JuliaDominiak/SpiderHand/3D Models/Construction/Part_2.stl

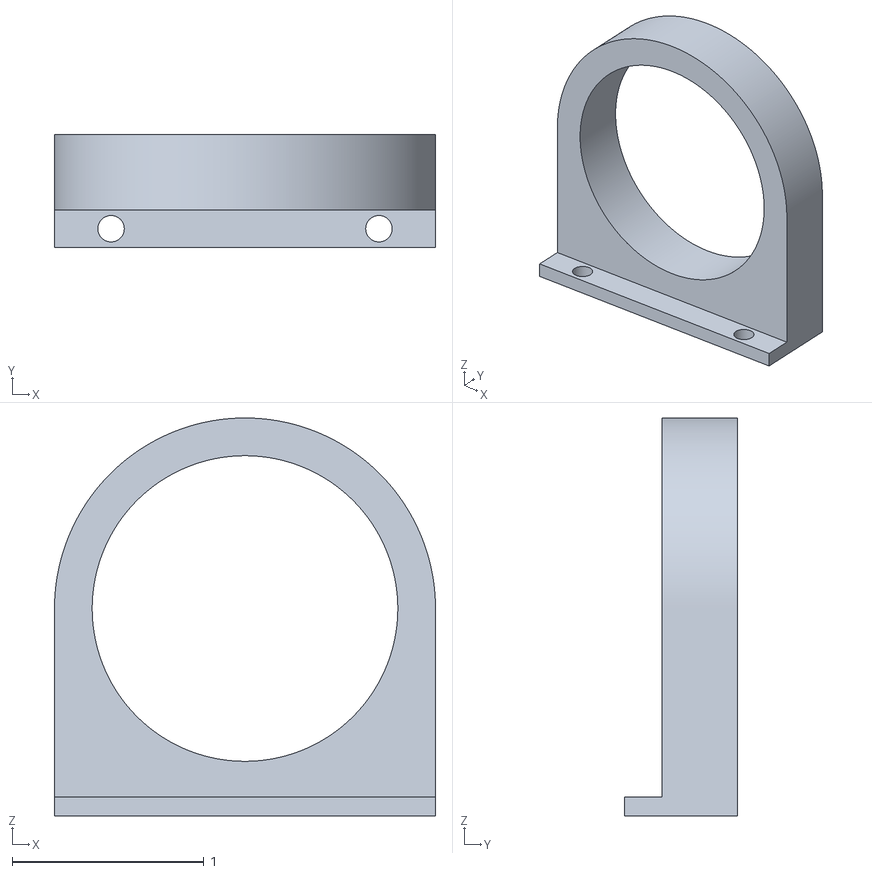
[picture p5: CAD file, 2020-11-13]
3D Models/Construction/Part_2.stl
1.99 x 0.591 x 2.08
