JuliaDominiak/SpiderHand/3D Models/Fingertips/Touch_3.stl

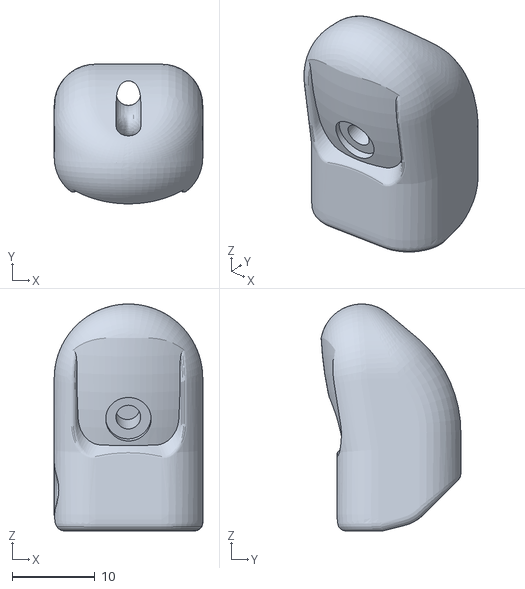
[picture p6: CAD file, 2020-11-13]
3D Models/Fingertips/Touch_3.stl
18.0 x 16.9 x 27.5
