JuliaDominiak/SpiderHand/3D Models/Sensors/bendlabs_2.stl

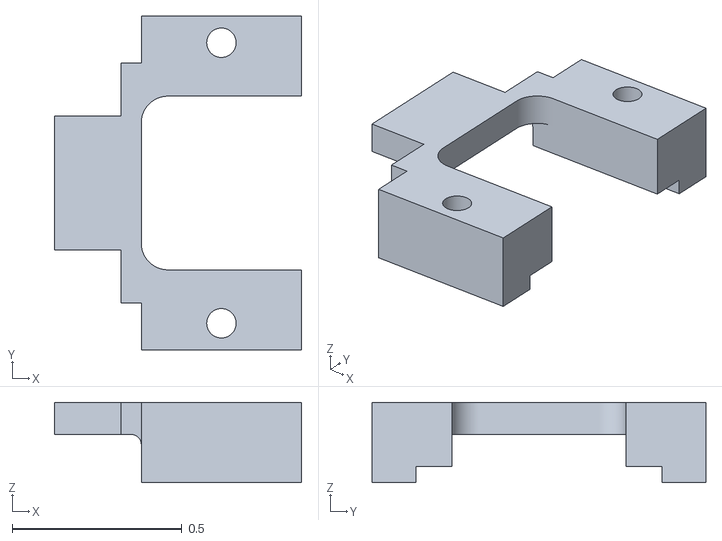
[picture p7: CAD file, 2020-11-13]
3D Models/Sensors/bendlabs_2.stl
0.728 x 0.984 x 0.236
