JuliaDominiak/SpiderHand/3D Models/Construction/Part_3.stl

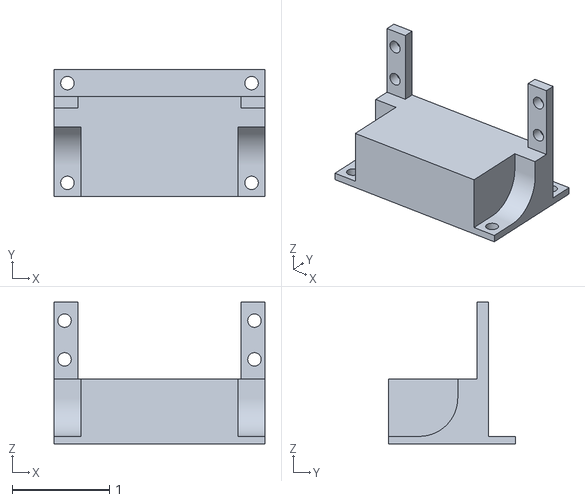
[picture p8: CAD file, 2020-11-13]
3D Models/Construction/Part_3.stl
2.17 x 1.30 x 1.46
