JuliaDominiak/SpiderHand/3D Models/Fingertips/Flex_2.stl

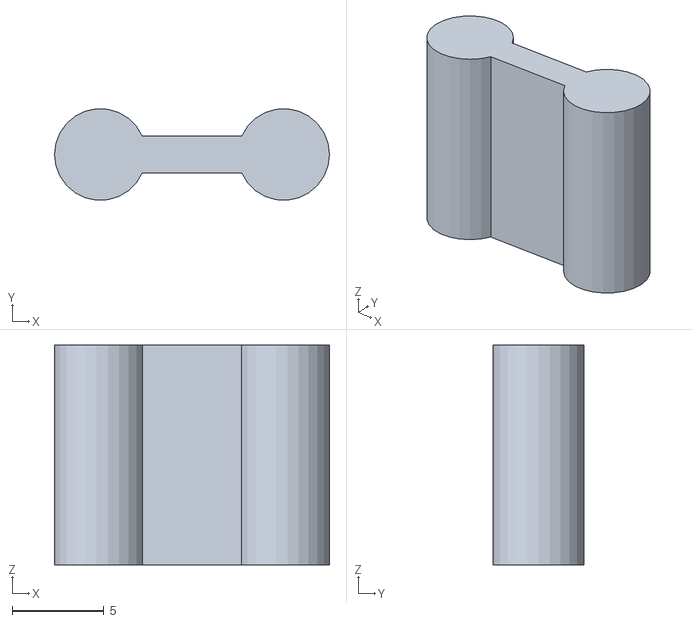
[picture p9: CAD file, 2020-11-13]
3D Models/Fingertips/Flex_2.stl
15.0 x 4.98 x 12.0
