JuliaDominiak/SpiderHand/3D Models/Sensors/Flex_2.stl

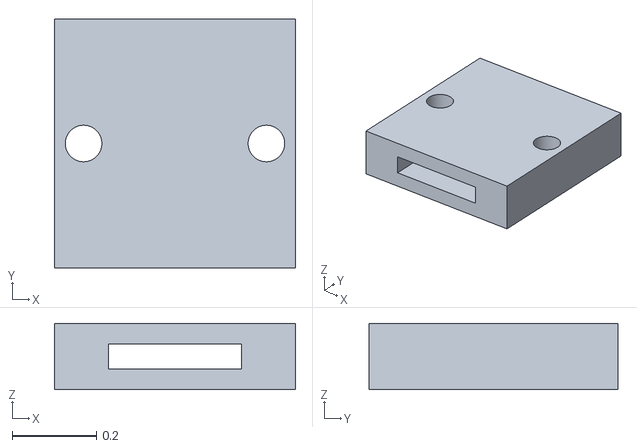
[picture p10: CAD file, 2020-11-13]
3D Models/Sensors/Flex_2.stl
0.571 x 0.591 x 0.157
