JuliaDominiak/SpiderHand/3D Models/Construction/Part_1.stl

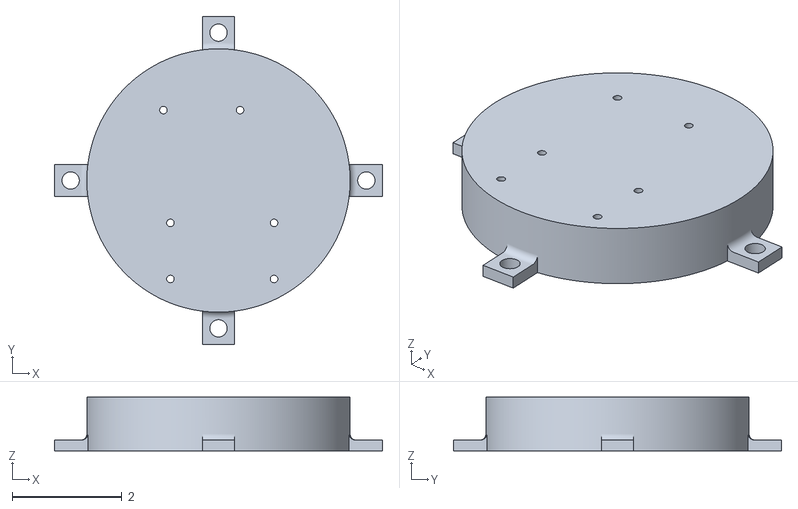
[picture p11: CAD file, 2020-11-13]
3D Models/Construction/Part_1.stl
5.98 x 5.98 x 0.984
