JuliaDominiak/SpiderHand/3D Models/Fingertips/Touch_2.stl

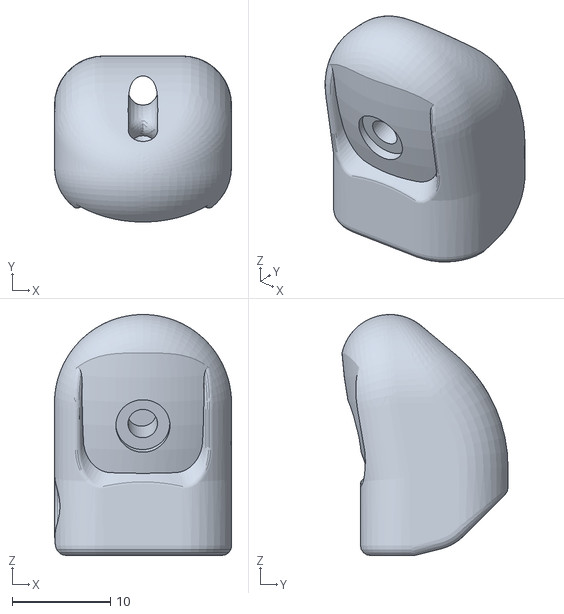
[picture p12: CAD file, 2020-11-13]
3D Models/Fingertips/Touch_2.stl
18.0 x 16.9 x 24.5
