JuliaDominiak/SpiderHand/3D Models/Sensors/2_2_.stl

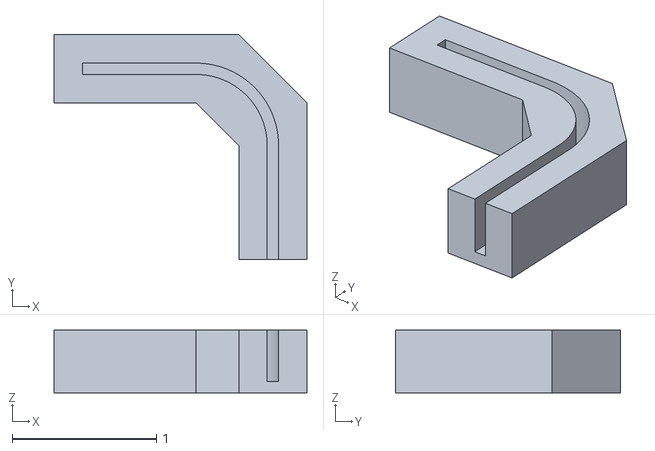
[picture p13: CAD file, 2020-11-13]
3D Models/Sensors/2_2_.stl
1.75 x 1.56 x 0.433
