JuliaDominiak/SpiderHand/3D Models/Construction/Part_6.stl

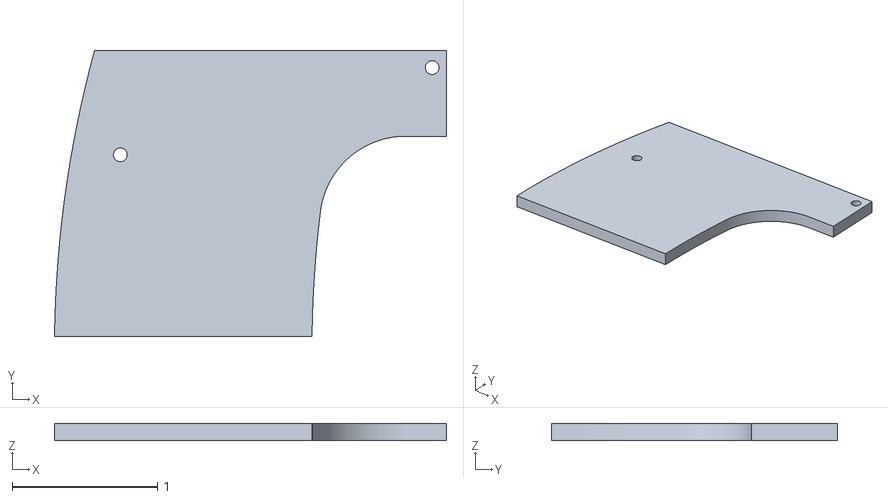
[picture p14: CAD file, 2020-11-13]
3D Models/Construction/Part_6.stl
2.70 x 1.97 x 0.118
