JuliaDominiak/SpiderHand/3D Models/Fingertips/Finger_5.1.stl

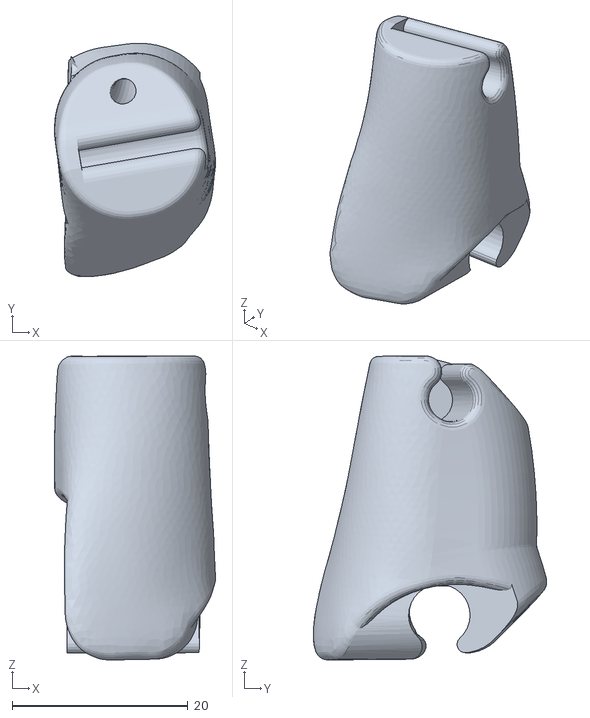
[picture p15: CAD file, 2020-11-13]
3D Models/Fingertips/Finger_5.1.stl
18.3 x 26.6 x 34.6
