JuliaDominiak/SpiderHand/3D Models/Sensors/4_5_.stl

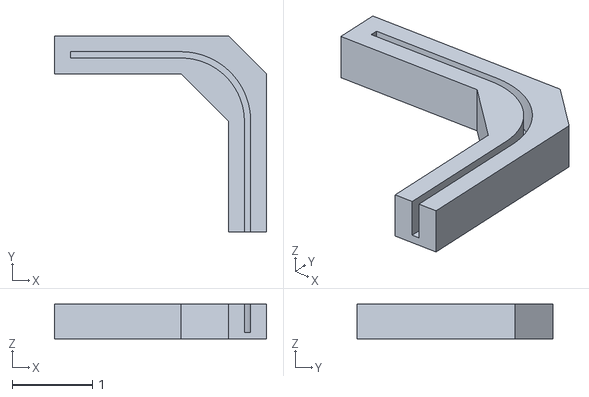
[picture p16: CAD file, 2020-11-13]
3D Models/Sensors/4_5_.stl
2.64 x 2.44 x 0.433
