JuliaDominiak/SpiderHand/3D Models/Construction/Part_10.stl

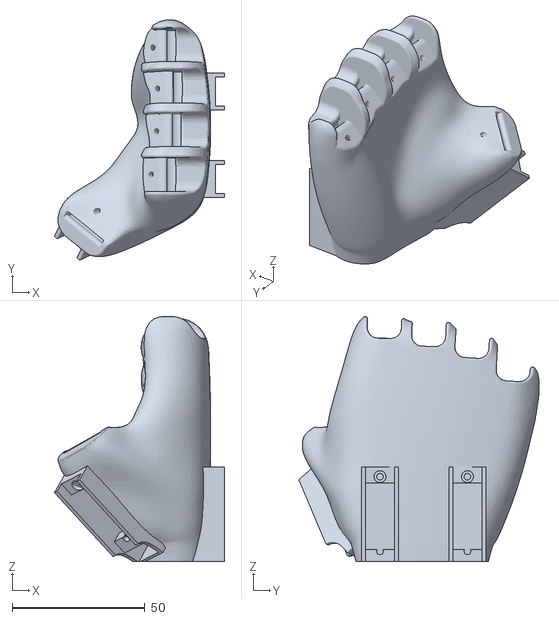
[picture p17: CAD file, 2020-11-13]
3D Models/Construction/Part_10.stl
64.2 x 90.7 x 92.4
