JuliaDominiak/SpiderHand/3D Models/Fingertips/Finger_5.2.stl

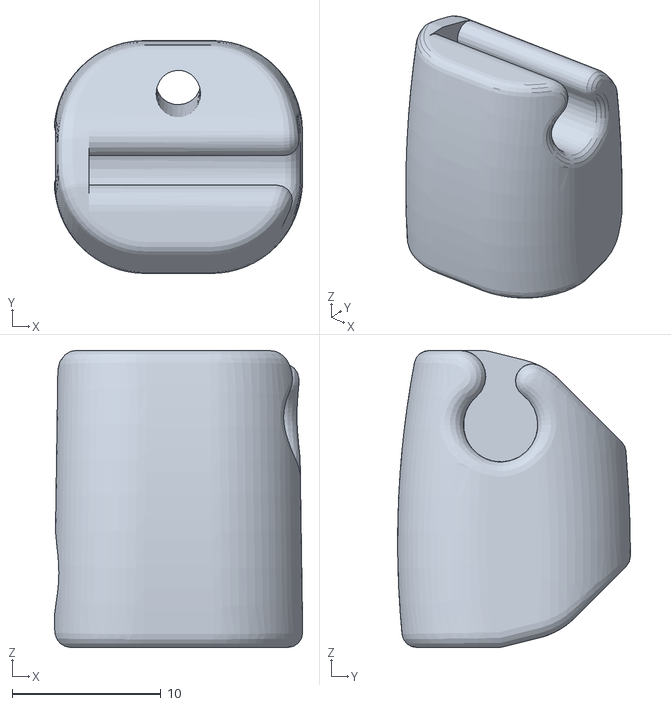
[picture p18: CAD file, 2020-11-13]
3D Models/Fingertips/Finger_5.2.stl
16.7 x 15.7 x 20.0
