JuliaDominiak/SpiderHand/3D Models/Sensors/bendlabs_1.stl

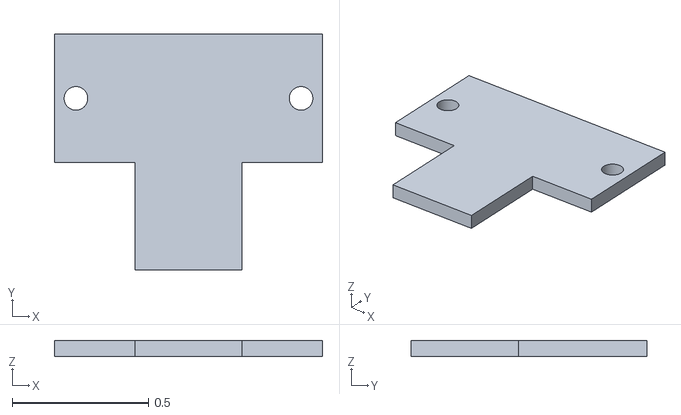
[picture p19: CAD file, 2020-11-13]
3D Models/Sensors/bendlabs_1.stl
0.984 x 0.866 x 0.0591
