JuliaDominiak/SpiderHand/3D Models/Construction/Part_4.stl

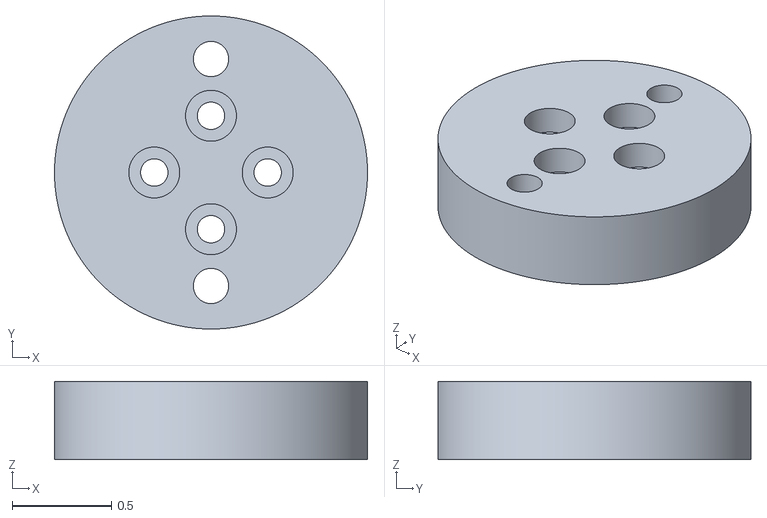
[picture p20: CAD file, 2020-11-13]
3D Models/Construction/Part_4.stl
1.57 x 1.57 x 0.394
