JuliaDominiak/SpiderHand/3D Models/Fingertips/Touch_5.stl

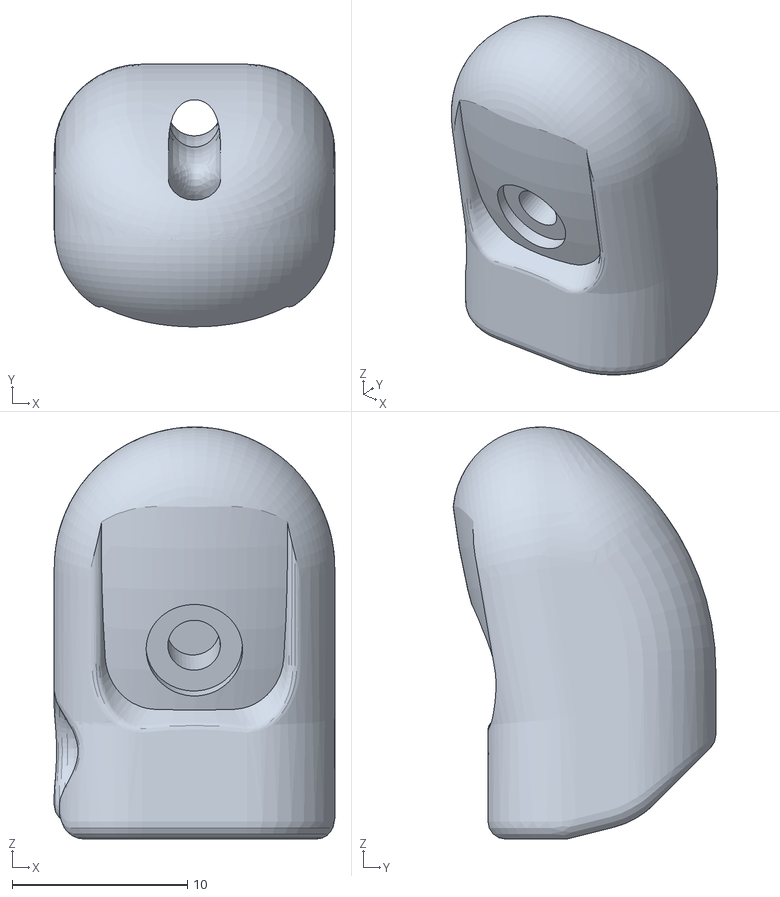
[picture p21: CAD file, 2020-11-13]
3D Models/Fingertips/Touch_5.stl
16.0 x 15.0 x 23.5
