JuliaDominiak/SpiderHand/3D Models/Sensors/bendlabs_3.stl

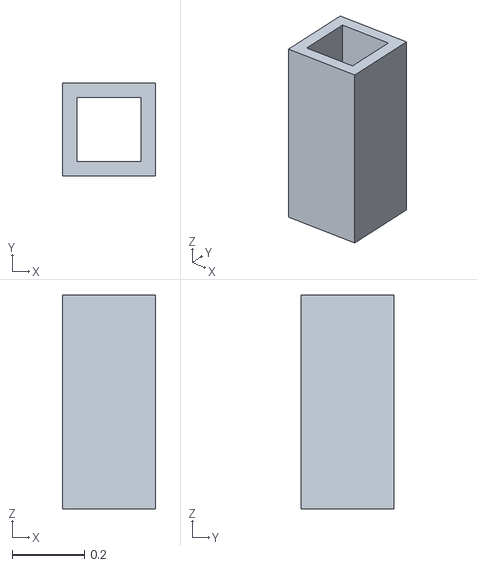
[picture p22: CAD file, 2020-11-13]
3D Models/Sensors/bendlabs_3.stl
0.256 x 0.256 x 0.591
