JuliaDominiak/SpiderHand/3D Models/Construction/Part_9.stl

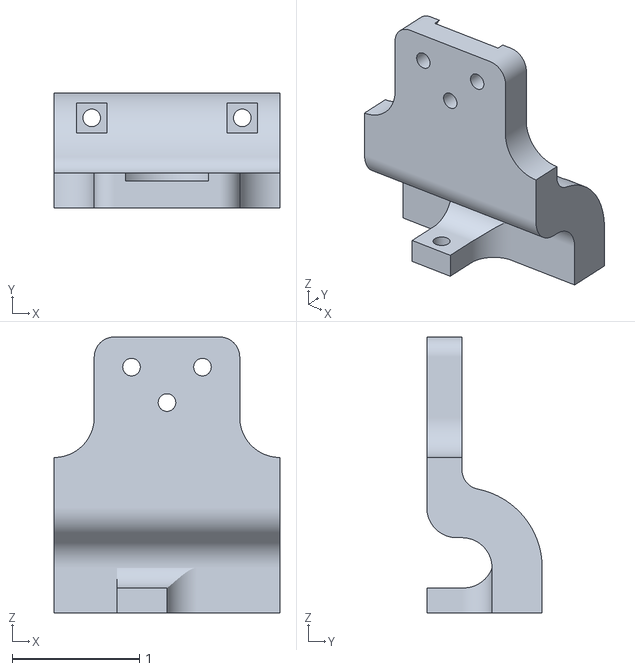
[picture p23: CAD file, 2020-11-13]
3D Models/Construction/Part_9.stl
1.77 x 0.906 x 2.17
