JuliaDominiak/SpiderHand/3D Models/Fingertips/Finger_3.1.stl

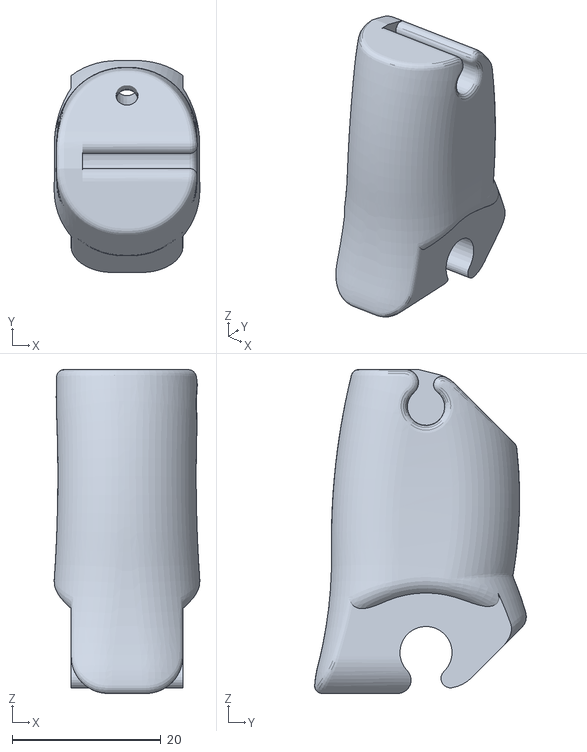
[picture p24: CAD file, 2020-11-13]
3D Models/Fingertips/Finger_3.1.stl
19.6 x 28.4 x 43.5
