JuliaDominiak/SpiderHand/3D Models/Sensors/Qwiic.stl

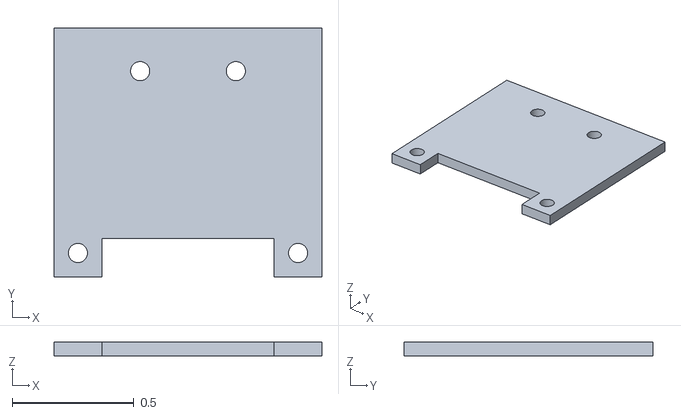
[picture p25: CAD file, 2020-11-13]
3D Models/Sensors/Qwiic.stl
1.10 x 1.02 x 0.0591
