JuliaDominiak/SpiderHand/3D Models/Construction/Part_5.stl

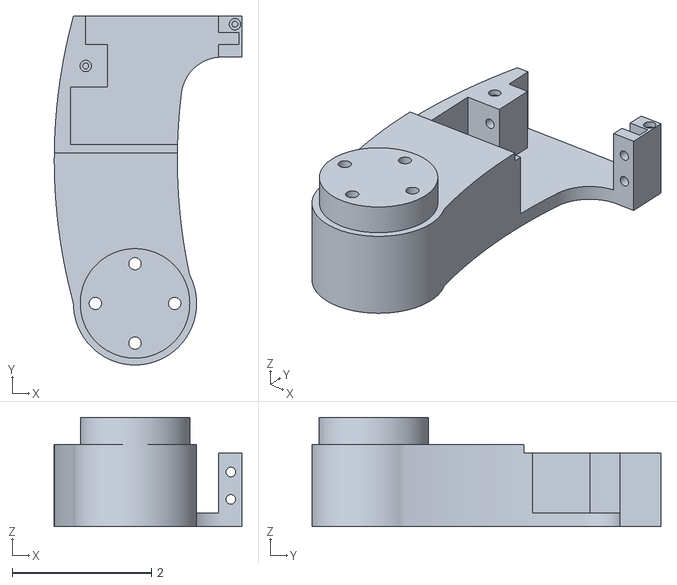
[picture p26: CAD file, 2020-11-13]
3D Models/Construction/Part_5.stl
2.70 x 5.02 x 1.57
