JuliaDominiak/SpiderHand/3D Models/Fingertips/Finger_3.2.stl

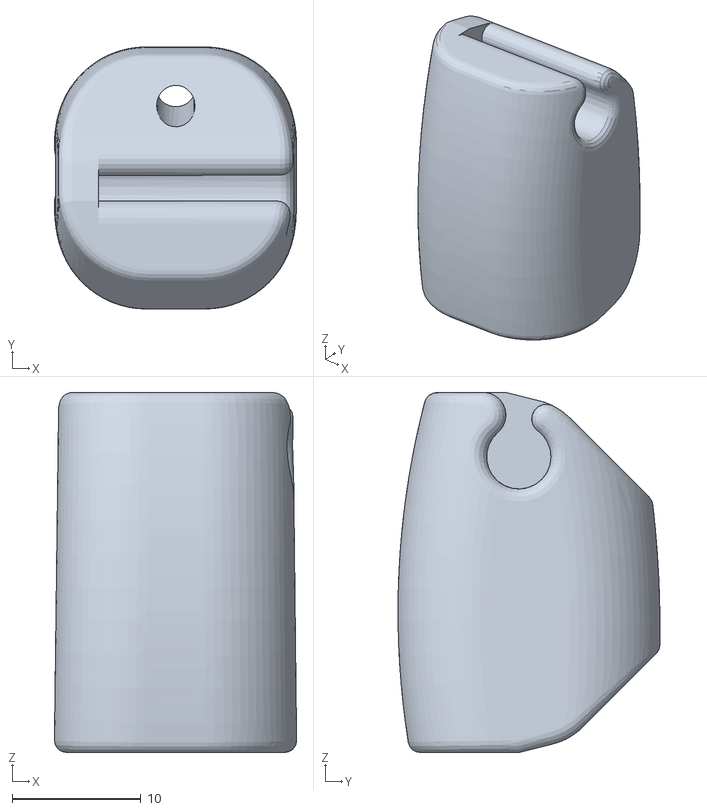
[picture p27: CAD file, 2020-11-13]
3D Models/Fingertips/Finger_3.2.stl
18.8 x 20.4 x 28.0
