JuliaDominiak/SpiderHand/3D Models/Sensors/DOF.stl

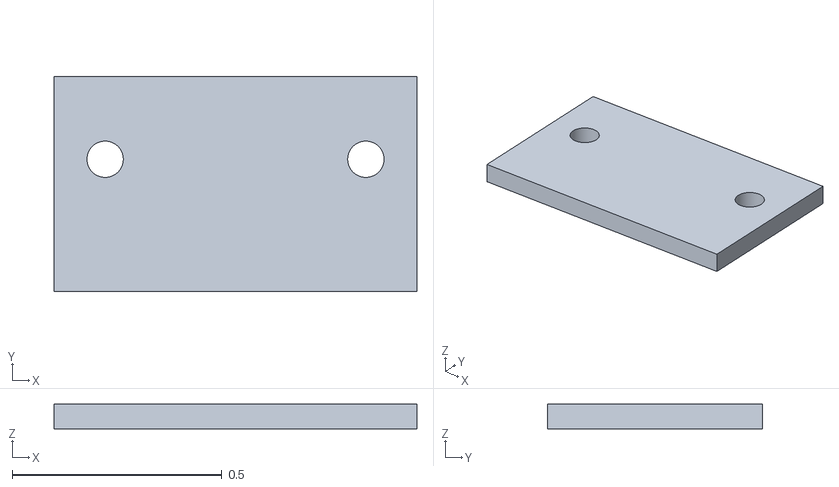
[picture p28: CAD file, 2020-11-13]
3D Models/Sensors/DOF.stl
0.866 x 0.512 x 0.0591
