JuliaDominiak/SpiderHand/3D Models/Fingertips/Touch_4.stl

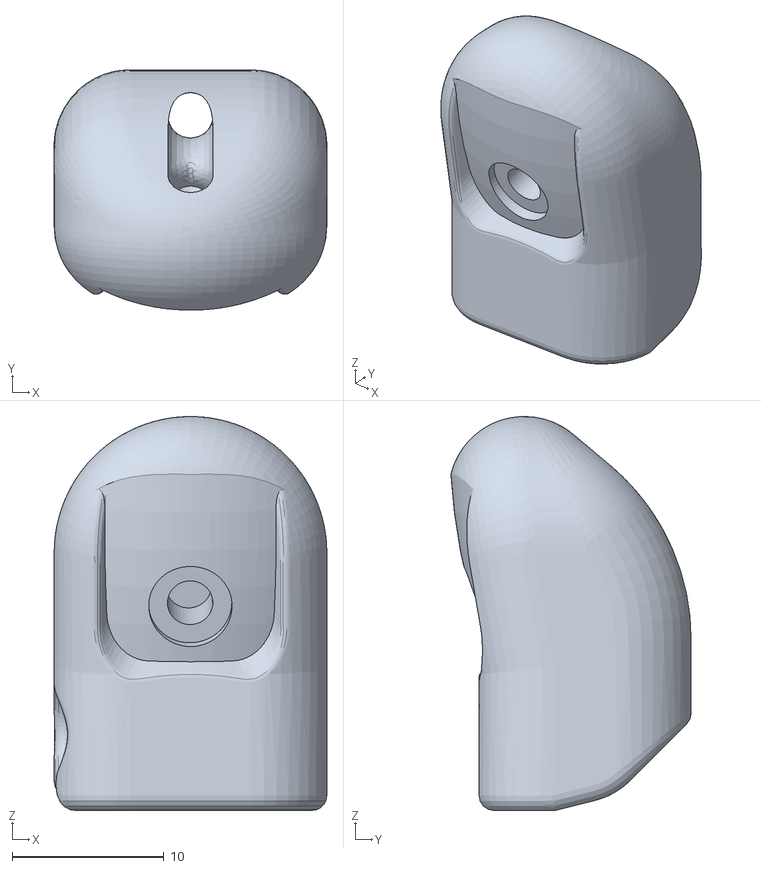
[picture p29: CAD file, 2020-11-13]
3D Models/Fingertips/Touch_4.stl
18.0 x 15.9 x 26.0
