JuliaDominiak/SpiderHand/3D Models/Sensors/Flex.stl

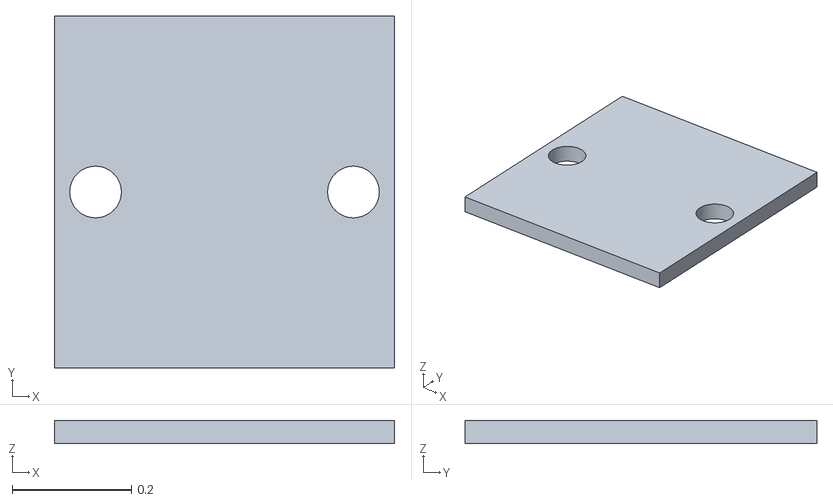
[picture p30: CAD file, 2020-11-13]
3D Models/Sensors/Flex.stl
0.571 x 0.591 x 0.0394
