JuliaDominiak/SpiderHand/3D Models/Fingertips/Touch_1.stl

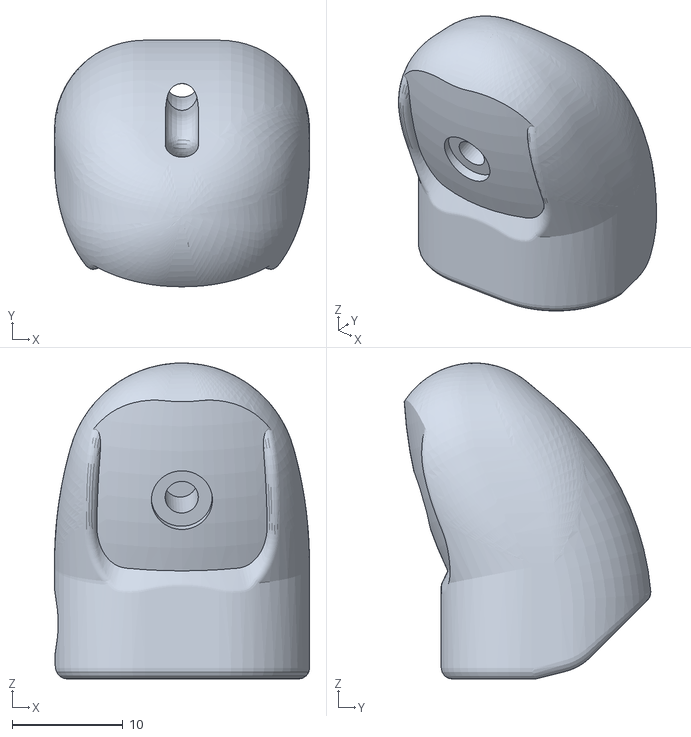
[picture p31: CAD file, 2020-11-13]
3D Models/Fingertips/Touch_1.stl
23.0 x 22.2 x 28.5
