JuliaDominiak/SpiderHand/3D Models/Fingertips/Finger_2.1.stl

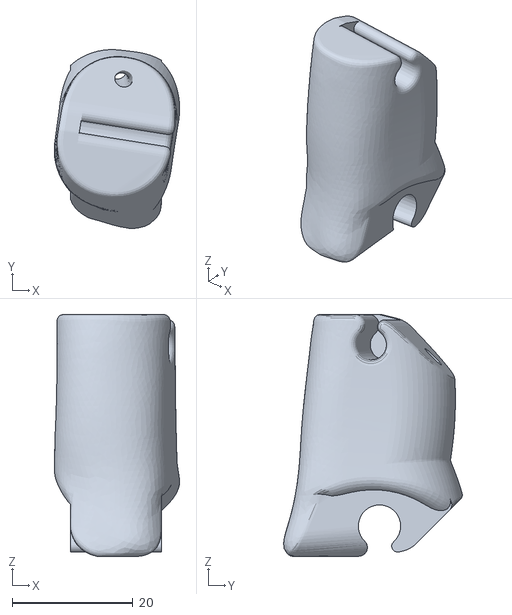
[picture p32: CAD file, 2020-11-13]
3D Models/Fingertips/Finger_2.1.stl
20.7 x 29.6 x 40.0
