JuliaDominiak/SpiderHand/3D Models/Fingertips/Finger_4.2.stl

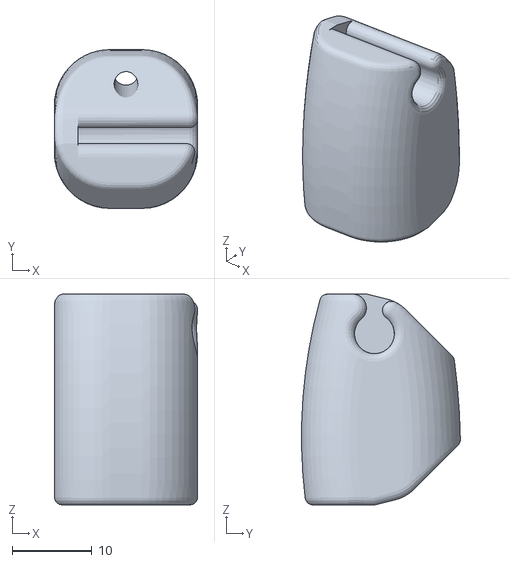
[picture p33: CAD file, 2020-11-13]
3D Models/Fingertips/Finger_4.2.stl
18.0 x 19.9 x 26.5
