JuliaDominiak/SpiderHand/3D Models/Fingertips/Finger_4.1.stl

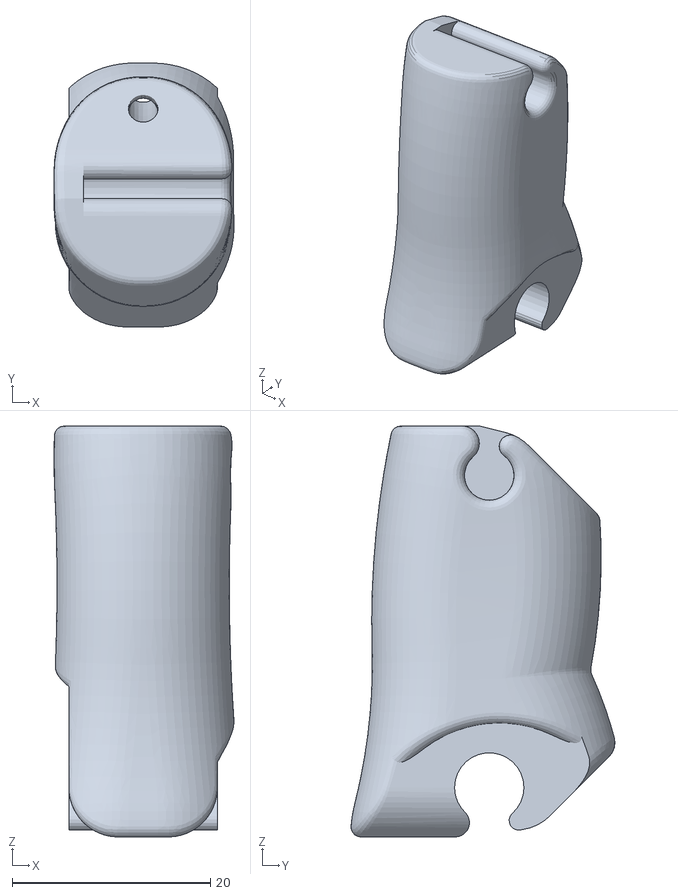
[picture p34: CAD file, 2020-11-13]
3D Models/Fingertips/Finger_4.1.stl
18.2 x 26.7 x 41.5
