JuliaDominiak/SpiderHand/3D Models/Fingertips/Finger_1.1.stl

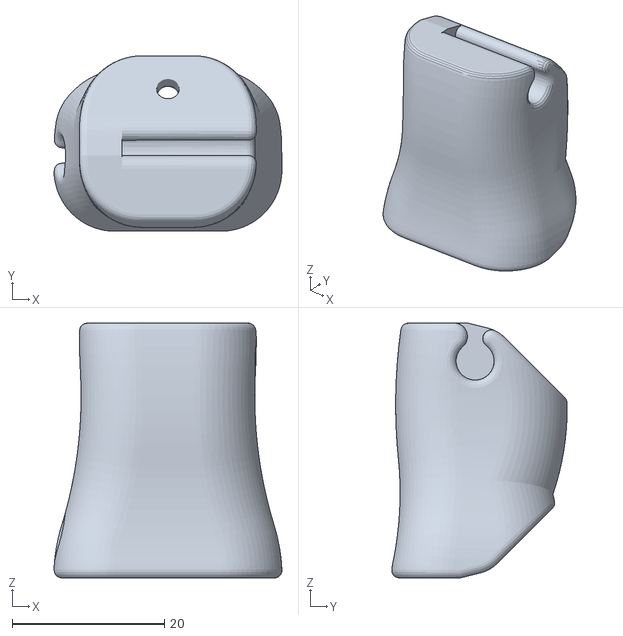
[picture p35: CAD file, 2020-11-13]
3D Models/Fingertips/Finger_1.1.stl
29.9 x 23.0 x 33.5
