JuliaDominiak/SpiderHand/3D Models/Fingertips/Flex_1.stl

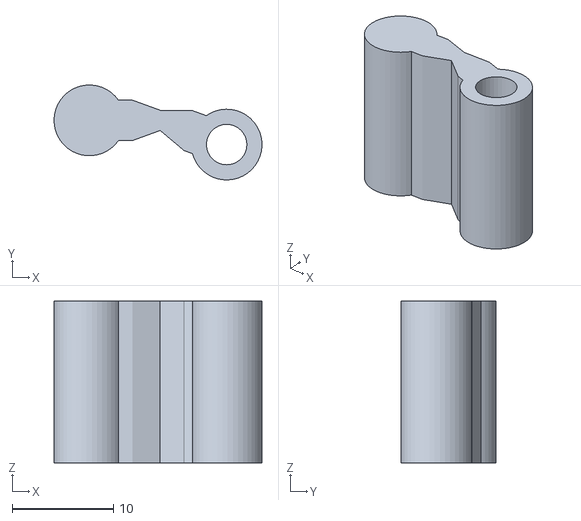
[picture p36: CAD file, 2020-11-13]
3D Models/Fingertips/Flex_1.stl
20.6 x 9.38 x 16.0
