JuliaDominiak/SpiderHand/3D Models/Fingertips/Finger_2.2.stl

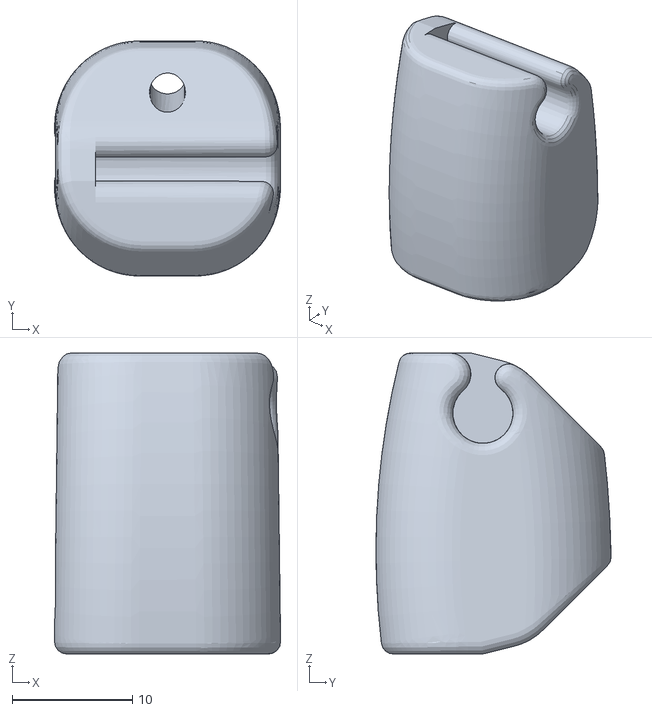
[picture p37: CAD file, 2020-11-13]
3D Models/Fingertips/Finger_2.2.stl
18.8 x 19.5 x 25.0
