JuliaDominiak/SpiderHand/Calibration.xlsx

Joint | control measurements |  | coefficients |  | PWM | Calibration of potentiometers |  |  |  | 0 | 0 | 1099 | 1099 | 0
Thumb | 0⁰ | 450 | a_thumb | -1.658767773 | 445 | R for 0⁰ [kΩ] | 36 | Rpot = | 55 | 0 | 77.08138506 | 1042.056995 | 964.9756098 | 5
 | 180⁰ | 661 | b_thumb | 1191.445498 | 95 | R for 90⁰ [kΩ] | 91.5 |  |  | 0 | 130.6371814 | 990.7241379 | 860.0869565 | 10
Index Finger | 0⁰ | 914 | a_index | 3.365384615 | 445 | VDD [V] | 3.3 |  |  | 0 | 168.4465617 | 944.2112676 | 775.7647059 | 15
 | 180⁰ | 810 | b_index | -2630.961538 | 95 | VDD Ang | 1099 |  |  | 0 | 195.3699552 | 901.8699552 | 706.5 | 20
Middle Finger | 0⁰ | 920 | a_middle | -4.069767442 | 95 |  |  |  |  | 0 | 214.5729262 | 863.1630901 | 648.5901639 | 25
 | 180⁰ | 834 | b_middle | 3839.186047 | 445 |  |  |  |  | 0 | 228.1874299 | 827.6419753 | 599.4545455 | 30
Wrist | 0⁰ | 0 | a_wrist | -2.222222222 | 500 |  |  |  |  | 0 | 237.6894171 | 794.9288538 | 557.2394366 | 35
 | 180⁰ | 180 | b_wrist | 500 | 100 |  |  |  |  | 0 | 244.1244747 | 764.7034221 | 520.5789474 | 40
Elbow | 0⁰ | 470 | a_elbow | -1.35106383 | 409 |  |  |  |  | 0 | 248.2478632 | 736.6923077 | 488.4444444 | 45
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
