JuliaDominiak/SpiderHand/PCB/SpiderHand.brd

## EAGLE design PCB/SpiderHand.brd (2020-11-13)

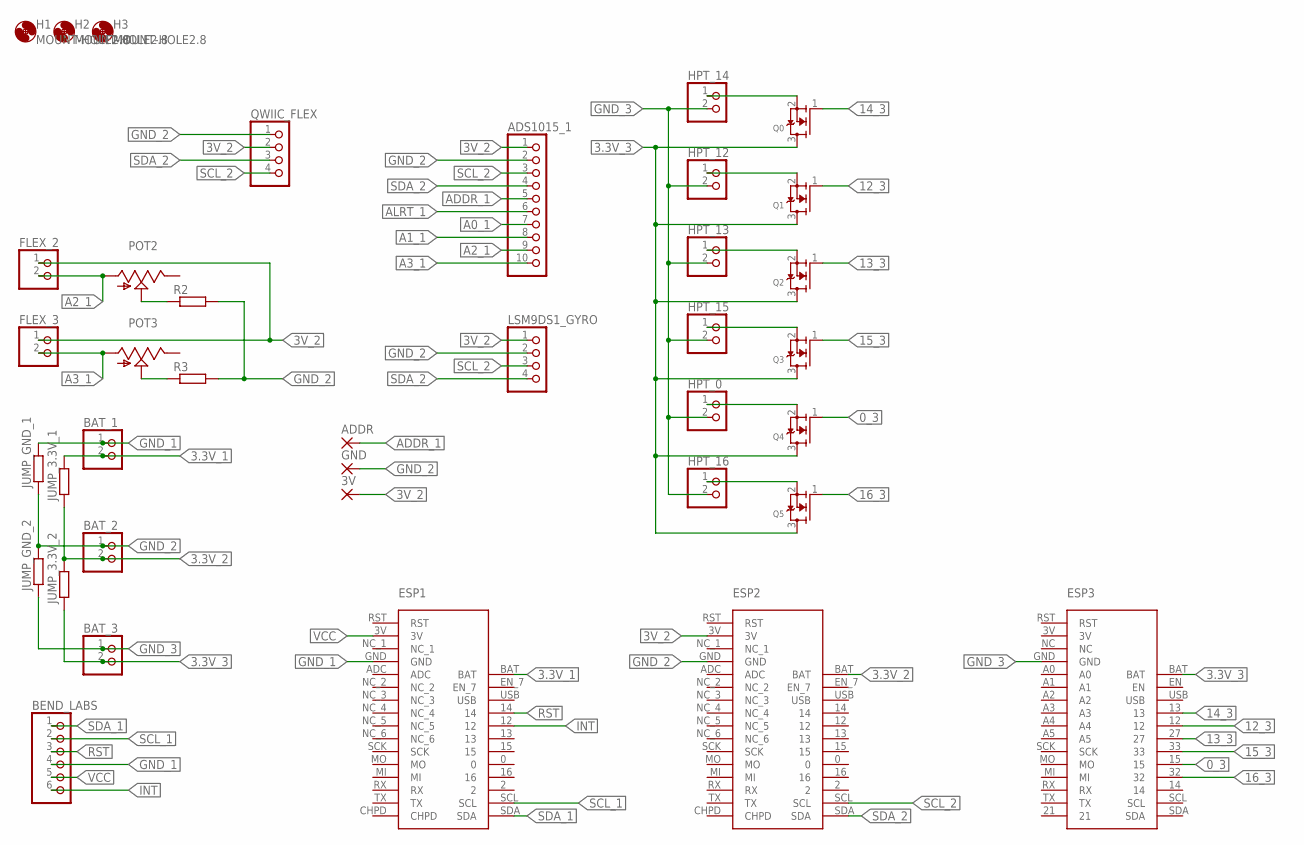
[picture p38: schematic SpiderHand.sch]

Parts:
3V: SMD2; SMD1,27-2,54
ADDR: SMD2; SMD1,27-2,54
ADS1015_1: PINHD-1X10; 1X10
BAT_1, BAT_2, BAT_3: PINHD-1X2; 1X02
BEND_LABS: PINHD-1X6/90; 1X06/90
ESP1, ESP2: ESP_8266_ADAFRUIT
ESP3: ESP_32_ADAFRUIT
FLEX_2, FLEX_3: PINHD-1X2; 1X02
GND: SMD2; SMD1,27-2,54
H1, H2, H3: MOUNT-HOLE2.8; 2,8
HPT_0, HPT_12, HPT_13, HPT_14, HPT_15, HPT_16: PINHD-1X2; 1X02
JUMP_3.3V_1, JUMP_3.3V_2: R-EU_M0805; M0805
JUMP_GND_1, JUMP_GND_2: R-EU_M0805; M0805
LSM9DS1_GYRO: PINHD-1X4/90; 1X04/90
POT2, POT3: TRIM_US-CA6V; CA6V
Q0, Q1, Q2, Q3, Q4, Q5: MOSFET-NREFLOW; SOT23
QWIIC_FLEX: PINHD-1X4/90; 1X04/90
R2, R3: R-EU_0204/7; 0204/7

Connections:
0_3: ESP3.15, Q4.1 (G)
3.3V_1: BAT_1.2, ESP1.BAT, JUMP_3.3V_1.2
3.3V_2: BAT_2.2, ESP2.BAT, JUMP_3.3V_1.1, JUMP_3.3V_2.2
3.3V_3: BAT_3.2, ESP3.BAT, JUMP_3.3V_2.1, Q0.3 (D), Q1.3 (D), Q2.3 (D), Q3.3 (D), Q4.3 (D), Q5.3 (D)
3V_2: 3V.1, ADS1015_1.1, ESP2.3V, FLEX_2.1, FLEX_3.1, LSM9DS1_GYRO.1, QWIIC_FLEX.2
12_3: ESP3.12, Q1.1 (G)
13_3: ESP3.27, Q2.1 (G)
14_3: ESP3.13, Q0.1 (G)
15_3: ESP3.33, Q3.1 (G)
16_3: ESP3.32, Q5.1 (G)
A0_1: ADS1015_1.7
A1_1: ADS1015_1.8
A2_1: ADS1015_1.9, FLEX_2.2, POT2.A
A3_1: ADS1015_1.10, FLEX_3.2, POT3.A
ADDR_1: ADDR.1, ADS1015_1.5
ALRT_1: ADS1015_1.6
GND_1: BAT_1.1, BEND_LABS.4, ESP1.GND, JUMP_GND_1.2
GND_2: ADS1015_1.2, BAT_2.1, ESP2.GND, GND.1, JUMP_GND_1.1, JUMP_GND_2.2, LSM9DS1_GYRO.2, QWIIC_FLEX.1, R2.2, R3.2
GND_3: BAT_3.1, ESP3.GND, HPT_0.2, HPT_12.2, HPT_13.2, HPT_14.2, HPT_15.2, HPT_16.2, JUMP_GND_2.1
INT: BEND_LABS.6, ESP1.12
unnamed: HPT_14.1, Q0.2 (S)
unnamed: HPT_12.1, Q1.2 (S)
unnamed: HPT_13.1, Q2.2 (S)
unnamed: HPT_15.1, Q3.2 (S)
unnamed: HPT_0.1, Q4.2 (S)
unnamed: HPT_16.1, Q5.2 (S)
unnamed: POT2.S, R2.1
unnamed: POT3.S, R3.1
RST: BEND_LABS.3, ESP1.14
SCL_1: BEND_LABS.2, ESP1.SCL
SCL_2: ADS1015_1.3, ESP2.SCL, LSM9DS1_GYRO.3, QWIIC_FLEX.4
SDA_1: BEND_LABS.1, ESP1.SDA
SDA_2: ADS1015_1.4, ESP2.SDA, LSM9DS1_GYRO.4, QWIIC_FLEX.3
VCC: BEND_LABS.5, ESP1.3V

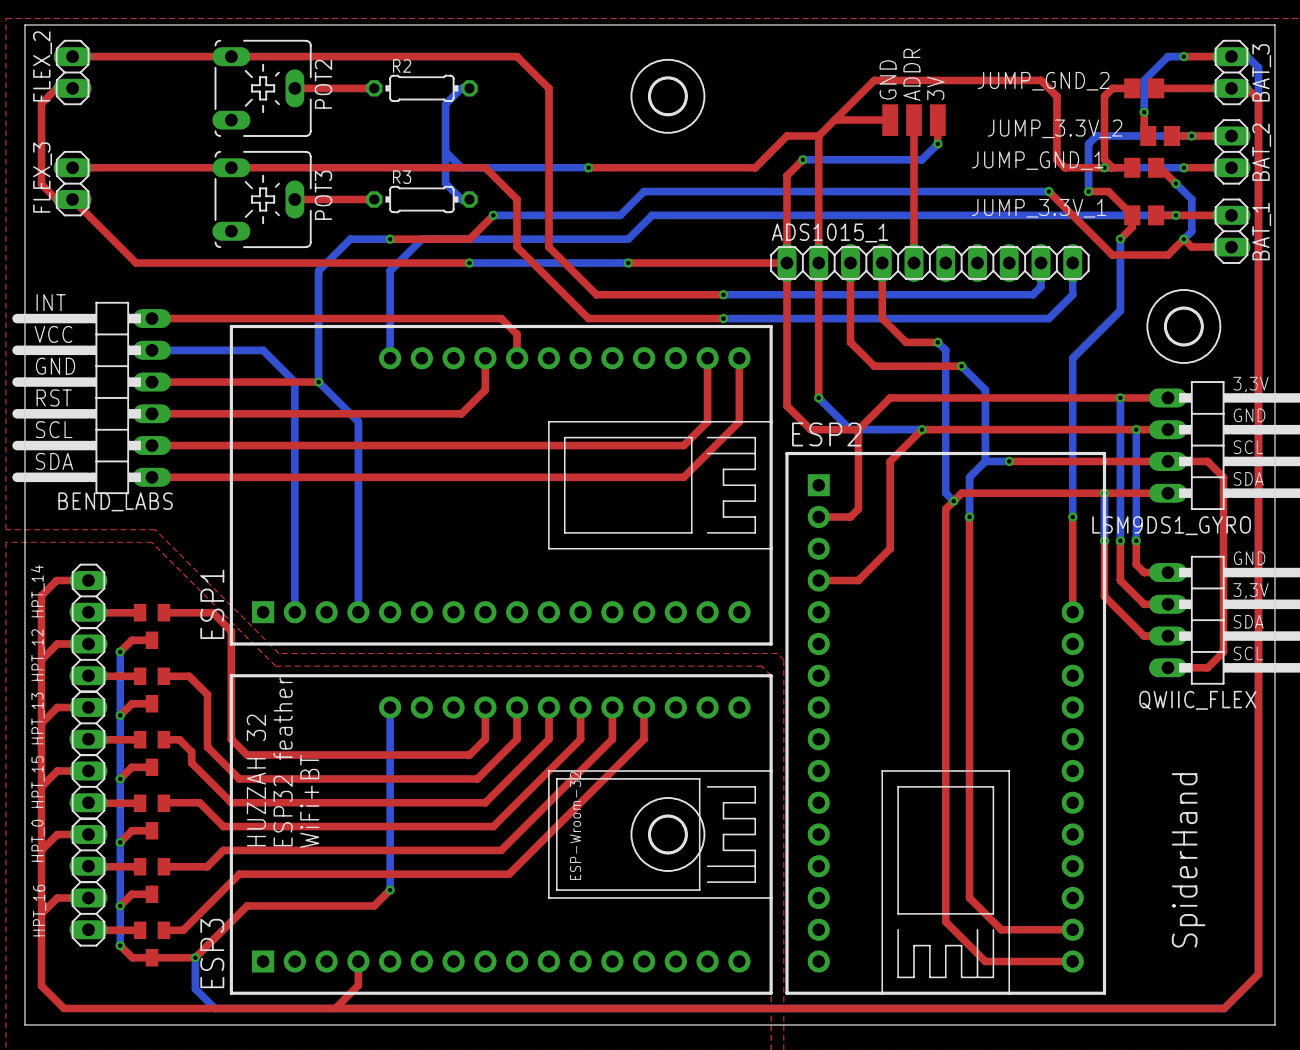
[picture p39: board SpiderHand.brd from above]

Board: 2 copper layers, 100.0 x 80.0 mm, 38 parts (0 on the bottom side), 31 nets.
