JuliaDominiak/SpiderHand/PCB/SpiderHand_BendLabs.brd

## EAGLE design PCB/SpiderHand_BendLabs.brd (2020-11-13)

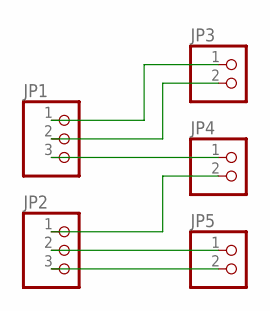
[picture p40: schematic SpiderHand_BendLabs.sch]

Parts:
JP1, JP2: PINHD-1X3; 1X03
JP3, JP4, JP5: PINHD-1X2; 1X02

Connections:
GND: JP2.1, JP4.2
INT: JP2.3, JP5.2
RST: JP1.3, JP4.1
SCL: JP1.2, JP3.2
SDA: JP1.1, JP3.1
VCC: JP2.2, JP5.1

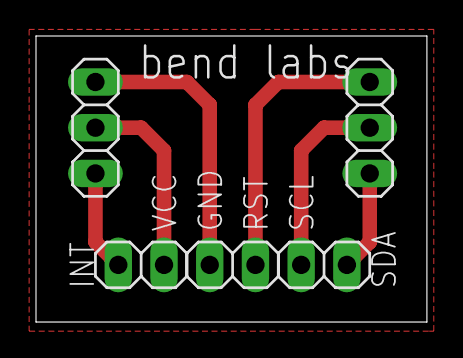
[picture p41: board SpiderHand_BendLabs.brd from above]

Board: 2 copper layers, 21.7 x 15.9 mm, 5 parts (0 on the bottom side), 6 nets.
